HarshaTalap1474/Intelligent-Eye-Controlled-Wheelchair/README.md

# 👁️ IrisDrive: Asynchronous Gaze-Controlled Wheelchair with Active Telemetry

> **"Vision to Motion"** — A robust assistive technology solution enabling hands-free wheelchair control through real-time eye tracking, embedded robotics, and closed-loop BLE telemetry.

    

---

## 📌 Overview

**IrisDrive** is an advanced assistive mobility system designed for individuals with severe motor impairments (e.g., ALS, Quadriplegia). It replaces the traditional joystick with a non-invasive, webcam-based **Gaze Interface**.

Unlike basic eye-tracking demos, IrisDrive features a **Signal Stabilization Engine (Kalman Filter)**, a **Multithreaded Bidirectional Bluetooth Architecture**, and **Hardware-Level Collision Avoidance**, ensuring smooth, jitter-free control and industrial-grade safety standards.

### 🏗️ System Architecture (Decoupled Client-Server)

The system is divided into two autonomous modules communicating via **Bluetooth Low Energy (BLE)** using Event-Driven Telemetry:

1.  **The Brain (Python/PC):** A multithreaded computer vision engine that tracks iris landmarks, filters noise, issues commands, and renders a live Heads-Up Display (HUD) with sensor data.
2.  **The Muscle (ESP32):** An embedded hardware controller that manages motor PWM, executes hardware-level pulse timers, actively scans dual ultrasonic sensors, and pushes collision alerts back to the PC.

---

## 🚀 Key Features

### 🧠 Software (Computer Vision & UI)
* **468-Point Mesh Tracking:** Utilizes Google MediaPipe for sub-millimeter iris and eyelid detection.
* **Kalman Filter Stabilization:** Implements a physics-based predictive model to eliminate "micro-tremors" and cursor jitter.
* **Asynchronous BLE Pipeline:** Dedicated background threading for Bluetooth prevents the video feed from freezing during data transmission.
* **Live Telemetry HUD:** Dynamically overlays real-time front and rear obstacle distances directly onto the user's camera feed.

### ⚙️ Firmware & Hardware (Embedded Systems)
* **Active Collision Avoidance:** Dual HC-SR04 sensors independently monitor proximity. If an object breaches 30cm, the ESP32 cuts the motors via a hardware interrupt in under 15ms.
* **The Pulse Logic Engine:** Continuous movement is physically restricted by the microcontroller (5s Forward, 2s Reverse) to prevent runaway scenarios if the PC connection drops.
* **Safe Logic-Level Shifting:** 5V ultrasonic ECHO signals are safely stepped down to 3.3V using precision 1.8kΩ and 3.3kΩ resistor voltage dividers, protecting the ESP32 silicon.
* **USB Backfeed Protection:** A Schottky diode physically isolates the USB data lines from the main motor battery supply.

---

## 🛠️ Tech Stack

| Domain | Technology / Library | Usage |
| :--- | :--- | :--- |
| **Language** | Python 3.10+, C++ | Core CV Logic & Embedded Firmware |
| **Vision** | OpenCV, MediaPipe | Face Mesh, Iris Extraction, HUD Rendering |
| **Math** | NumPy | Vector Calculus & Kalman Filtering |
| **Comms** | Bleak (Python), BLE2902 | Bidirectional Event-Driven Wireless Control |
| **MCU** | ESP32 DevKit V1 | Real-time Motor & Sensor Management |
| **Drivers** | L298N Dual H-Bridge | High Current Motor Driving |

---

## 📦 Hardware Bill of Materials (BOM)

| Component | Quantity | Specs | Function |
| :--- | :---: | :--- | :--- |
| **ESP32 DevKit V1** | 1 | 30-Pin, WiFi/BLE | Central Processing Unit |
| **L298N Driver** | 1 | Dual H-Bridge, 2A | Motor Power Distribution |
| **Ultrasonic Sensors** | 2 | HC-SR04 (5V) | Front and Rear Collision Radar |
| **Resistors** | 2x Sets| 1.8kΩ & 3.3kΩ | 5V to 3.3V Logic Level Shifting |
| **Diode** | 1 | 1N5817 Schottky | Reverse Current/USB Backfeed Protection |
| **DC Gear Motors** | 4 | 300 RPM, 12V | BO Type High-Torque |
| **Battery Pack** | 2 | 18650 Li-Ion (7.4V) | Main Power Source |
| **Webcam** | 1 | 720p/1080p | Gaze Input Sensor |

---

## 🔌 Verified Circuit & Pin Mapping

**⚠️ Critical Power Routing:** The 1N5817 Diode must be placed in series between the L298N 5V output and the ESP32 VIN pin to prevent USB backfeeding.

| ESP32 GPIO | Component Pin | Function |
| :---: | :---: | :--- |
| **GPIO 13 / 23** | ENA / ENB | PWM Speed Control (Left / Right) |
| **GPIO 18 / 19** | IN1 / IN2 | Left Motor Logic |
| **GPIO 14 / 27** | IN3 / IN4 | Right Motor Logic |
| **GPIO 05 / 21** | F_TRIG / F_ECHO | Front Ultrasonic Sensor (ECHO via Divider) |
| **GPIO 32 / 33** | R_TRIG / R_ECHO | Rear Ultrasonic Sensor (ECHO via Divider) |

### ⚡ Voltage Divider Schematic (Required for ECHO pins)

To prevent 5V signals from destroying the 3.3V ESP32 GPIOs, the ECHO pins for both sensors must be wired through a junction:
`Sensor ECHO -> [1.8kΩ Resistor] -> (Junction to ESP32 Pin) -> [3.3kΩ Resistor] -> GND`

---

## 💾 Installation & Setup

### 1️⃣ PC Setup (The Brain)
**Prerequisites:** Python 3.10+ installed.
```bash
# Clone the Repository
git clone [https://github.com/HarshaTalap1474/IrisDrive.git](https://github.com/HarshaTalap1474/IrisDrive.git)
cd IrisDrive

# Install Dependencies
pip install opencv-python mediapipe numpy bleak asyncio
```

### 2️⃣ ESP32 Setup (The Muscle)

Follow these steps to upload the firmware to your ESP32 board:

1. **Open Arduino IDE**  
   Launch the Arduino IDE on your computer.

2. **Install ESP32 Board Manager**  
   - Go to **File → Preferences**  
   - Add the ESP32 board URL in **Additional Board Manager URLs**  
   - Then navigate to **Tools → Board → Boards Manager**  
   - Search for **ESP32** and click **Install**

3. **Select the Correct Board**  
   Go to:  
   **Tools → Board → ESP32 Arduino → DOIT ESP32 DEVKIT V1**

4. **Open the Firmware File**  
   Open the following file in Arduino IDE:  
   `Firmware/Wheelchair_BLE.ino`

5. **Upload the Code to ESP32**  
   Connect your ESP32 via USB and click the **Upload** button.
---
## 🕹️ User Guide

### Step 1: Calibration

1. Sit comfortably in front of the webcam (approximately **50 cm** away).
2. Run the main script:

   ```bash
   python main.py
   ```
3. Look at the center of the screen and press C.
4. The system is now calibrated to your neutral gaze.

### Step 2: Driving & HUD
The system follows a "Look-to-Act" protocol with live on-screen UI feedback.
| Gaze Direction | Robot Action | Visual Indicator |
|---|---|---|
| Look **UP** | Pulse Forward *(max 5s)* | 🟢 Green Arrow UP |
| Look **DOWN** | Pulse Backward *(max 2s)* | 🟢 Green Arrow DOWN |
| Look **LEFT** | Step Turn *(max 0.8s)* | 🟢 Green Arrow LEFT |
| Look **RIGHT** | Step Turn *(max 0.8s)* | 🟢 Green Arrow RIGHT |
| Double Blink | **EMERGENCY STOP** | 🔴 Red HUD Warning |

---
## 🛡️ Industrial Safety Protocols

IrisDrive is designed with a strictly decoupled **"Safety First" architecture**, ensuring reliable operation even under fault conditions.

### 🔧 Hardware Interrupt Braking
The ESP32 does **not** wait for PC authorization to stop.  
If the **HC-SR04 ultrasonic sensor** detects an obstacle within **30 cm**, the microcontroller instantly cuts motor PWM, applying an immediate brake.

### ⚙️ The Pulse Engine
Forward motion is executed only in short, timed pulses.  
If the **Bluetooth connection is lost** during movement, the wheelchair will automatically coast to a stop after **exactly 5 seconds**, preventing runaway crashes.

### 👁️ Double-Blink Kill Switch
A deliberate **double blink** acts as a global emergency stop.  
This triggers an immediate software brake, forcing the system into an **IDLE lock state** until reset.

---
## 🔮 Future Roadmap

- [x] **Obstacle Avoidance**  
  Integrated dual **HC-SR04 sensors** for automatic braking.

- [x] **Bidirectional Telemetry**  
  Implemented live sensor data broadcasting to the PC HUD.

- [ ] **Infrared (IR) Tracking**  
  Migrating from RGB webcams to IR cameras for total-darkness operation.

- [ ] **LiDAR Mapping**  
  Adding 2D SLAM via ROS for semi-autonomous navigation to visual targets.

- [ ] **Battery Telemetry**  
  Adding an ADC voltage divider to broadcast the 12V Li-Ion battery percentage to the Python UI.

---
## 📜 License & Credits

**Developer:** Harshvardhan Talap  
Embedded Systems & Telecommunication Engineer  

This project is licensed under the **MIT License** — free for educational and research use.

---

⚠️ **Note:**  
This project is a prototype. While it includes advanced electrical and software safety features, it is **not** a medically certified device.  
Please use with caution and only in controlled environments.
