HarshaTalap1474/Intelligent-Eye-Controlled-Wheelchair/(commit log)

2026-02-13 Added Arduino Sketch
2026-02-14 Added wifi and bluetooth control to wheelchair
2026-02-15 Fixed some issues and improved system performance
    [Test_connection_motor.ino, WIFI_STATION_MODE.ino, ble_wheelchair.ino, ble_wheelchair.py]
2026-02-15 readme stage 1 update
2026-02-17 Fixed Python detection issues and added reconnect feature for esp
    [Wheelchair_ESP32.ino]
2026-02-19 Added SR04 sensors for distance calculation
