HarshaTalap1474/Intelligent-Eye-Controlled-Wheelchair/(notices)

Notices in the files:
README.md:
License: MIT
